liorknafo/totem-aluminum-case/outputs/clearance_L.png

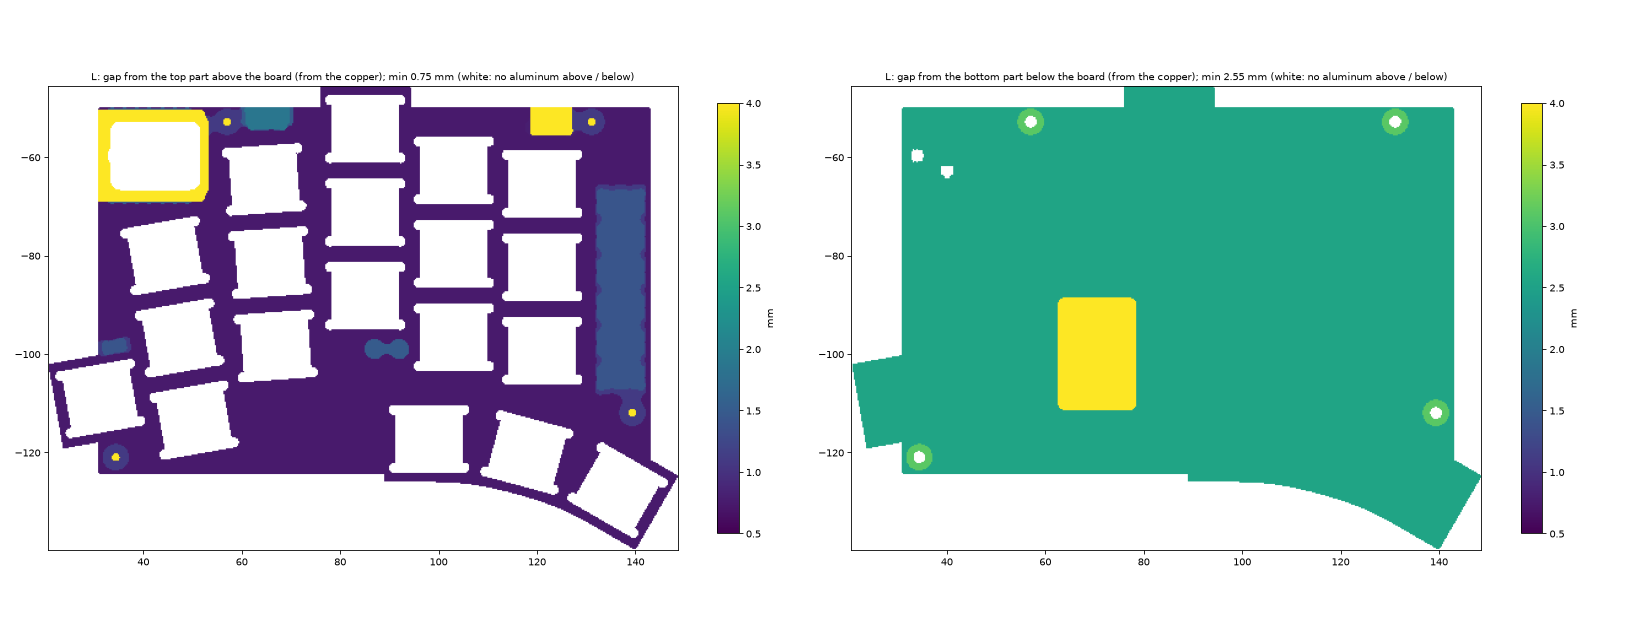
outputs/clearance_L.png
