liorknafo/totem-aluminum-case/outputs/heightmap_L.png

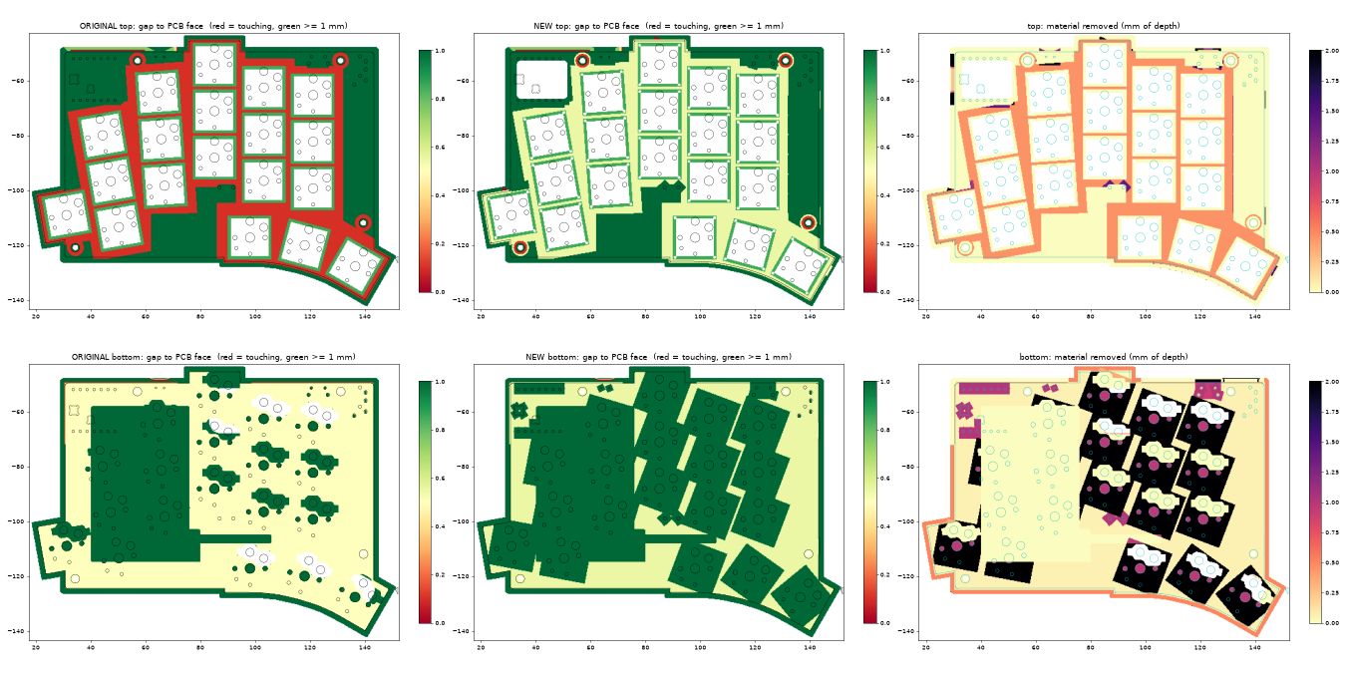
outputs/heightmap_L.png
