liorknafo/totem-aluminum-case/outputs/heightmap_R.png

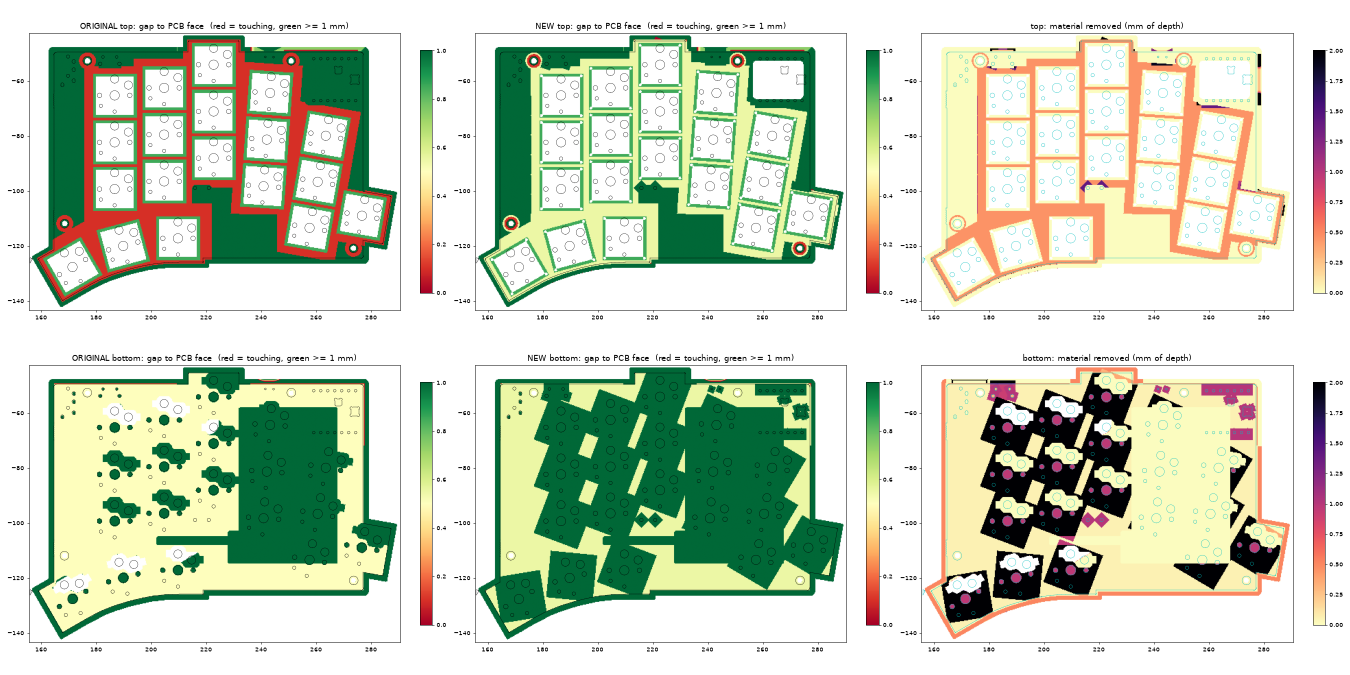
outputs/heightmap_R.png
