liorknafo/totem-aluminum-case/outputs/openings_L.png

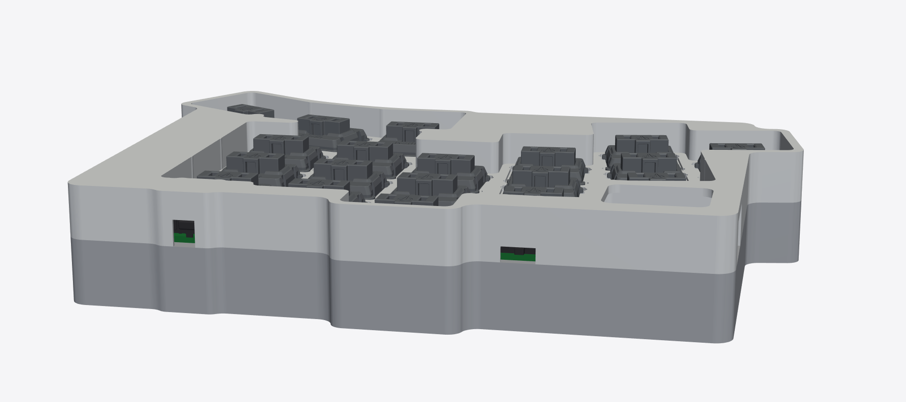
outputs/openings_L.png
