liorknafo/totem-aluminum-case/outputs/render3d_L.png

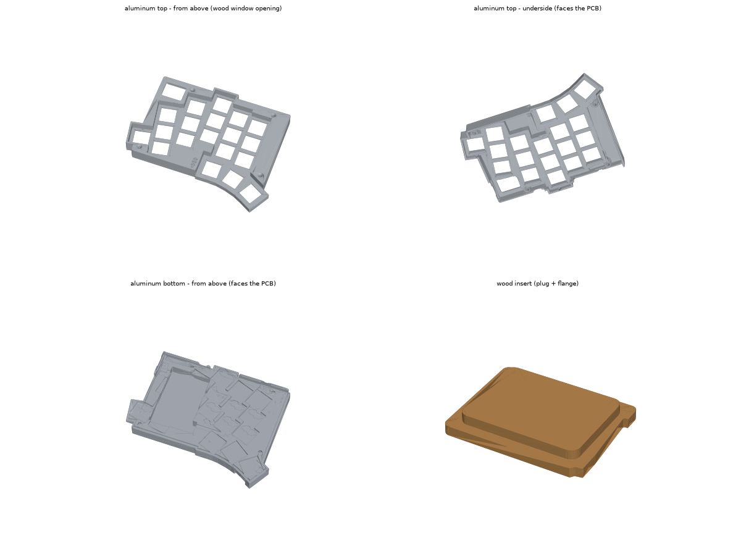
outputs/render3d_L.png
