liorknafo/totem-aluminum-case/outputs/reset_back.png

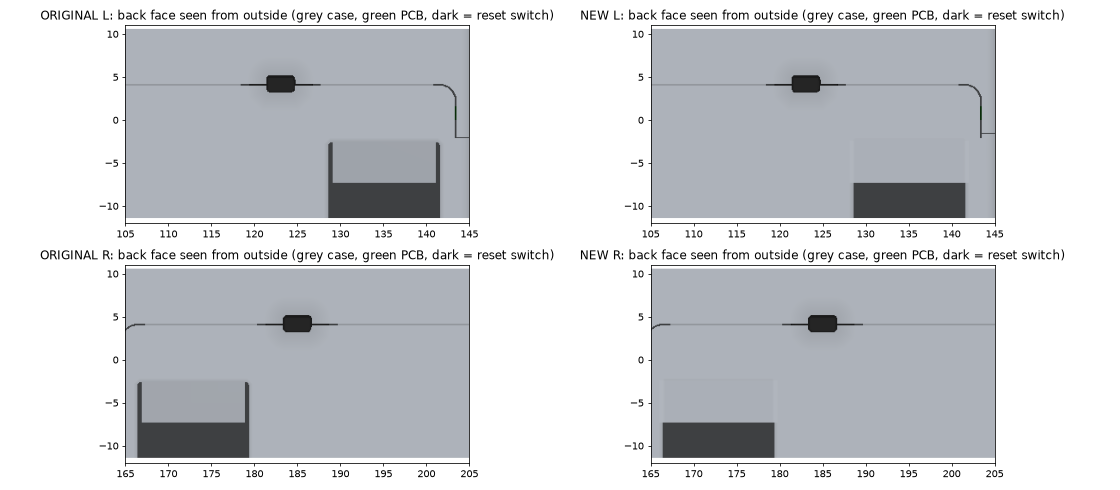
outputs/reset_back.png
