liorknafo/totem-aluminum-case/outputs/sections_L.png

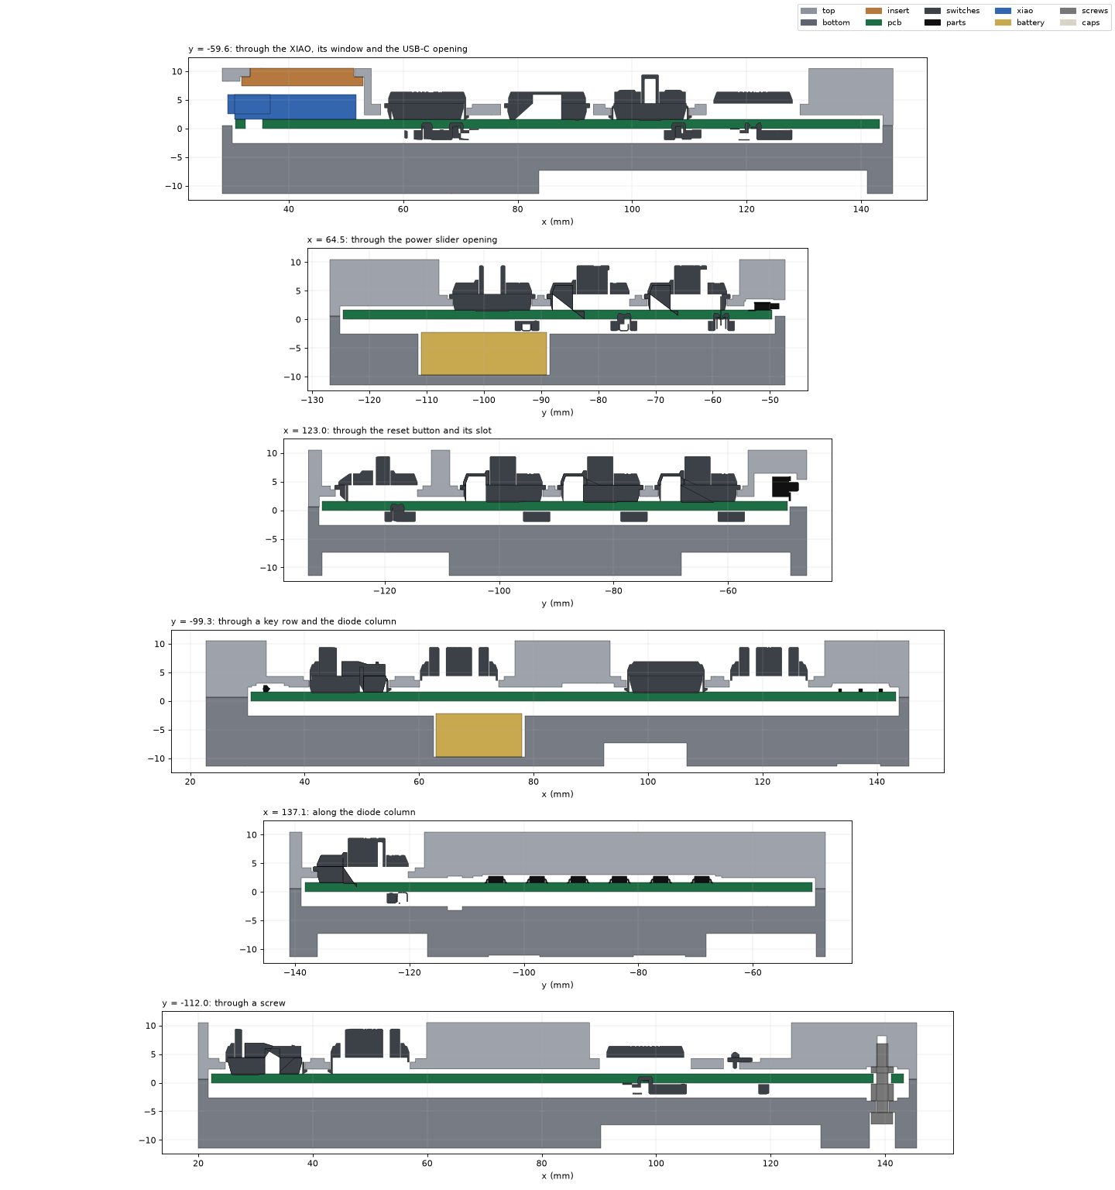
outputs/sections_L.png
