liorknafo/totem-aluminum-case/outputs/underside_holes.png

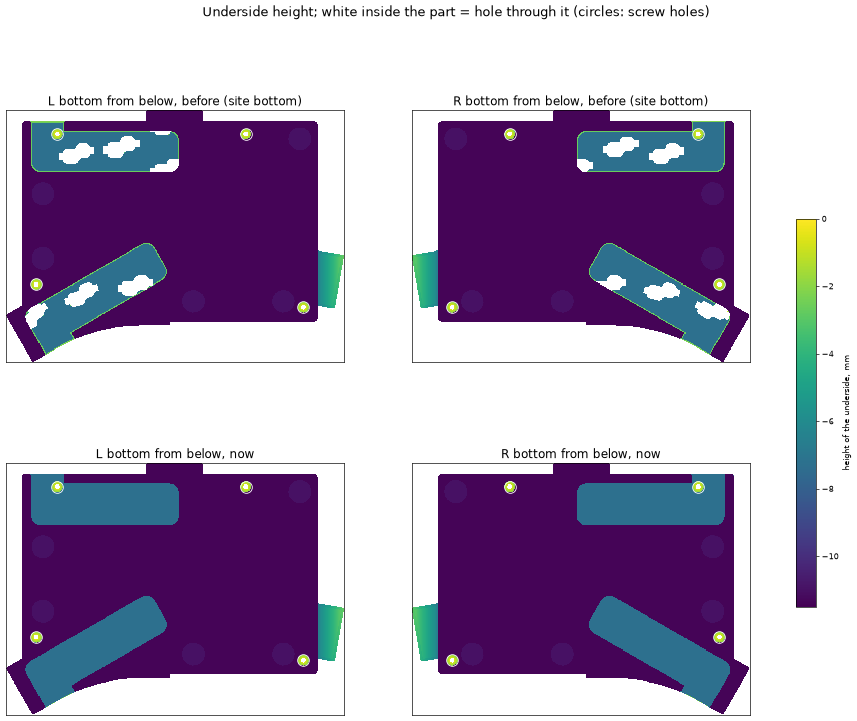
outputs/underside_holes.png
