liorknafo/totem-aluminum-case/outputs/TOTEM_wood_window_insert_L.step

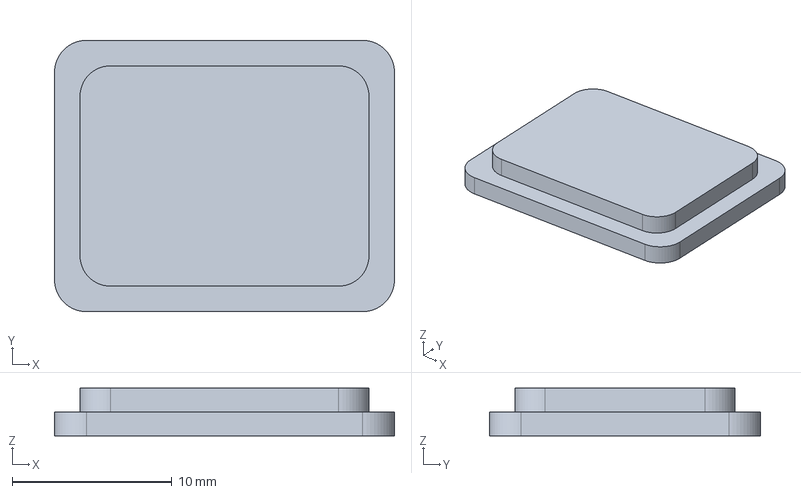
[picture p15: CAD file, 2026-11-09]
outputs/TOTEM_wood_window_insert_L.step
21.3 x 17.0 x 3.00 mm
