liorknafo/totem-aluminum-case/src/pcb_board.step

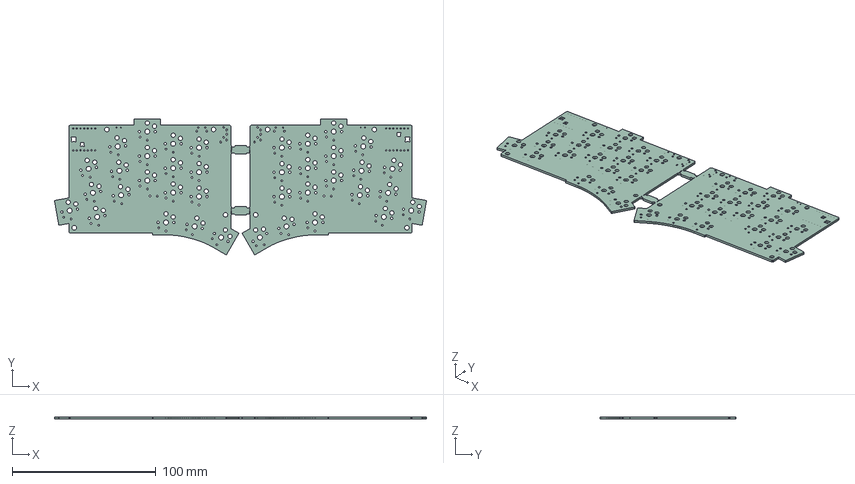
[picture p16: CAD file, 2026-10-20]
src/pcb_board.step
258.7 x 94.4 x 1.51 mm
