liorknafo/totem-aluminum-case/work/orig/TOTEM_tenting_live_bottom_L.step

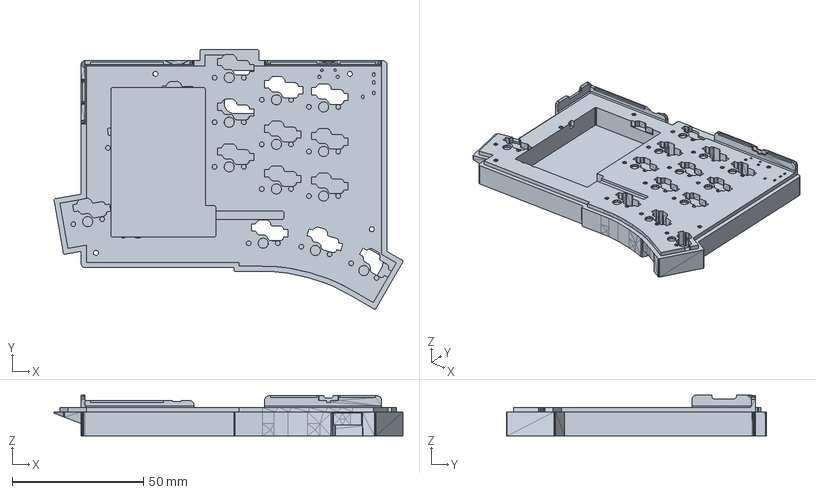
[picture p17: CAD file, 2026-10-20]
work/orig/TOTEM_tenting_live_bottom_L.step
133.1 x 99.0 x 15.6 mm
