liorknafo/totem-aluminum-case/outputs/TOTEM_alu_bottom_L.step

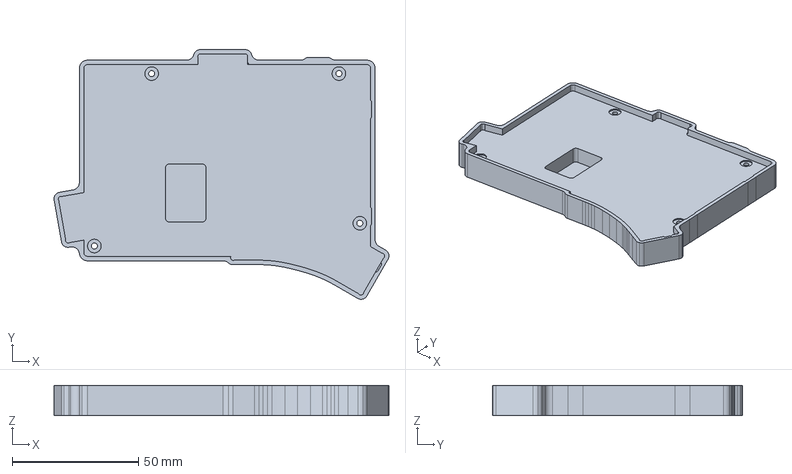
[picture p18: CAD file, 2026-11-09]
outputs/TOTEM_alu_bottom_L.step
132.8 x 98.9 x 12.0 mm
