liorknafo/totem-aluminum-case/src/comp_all.step

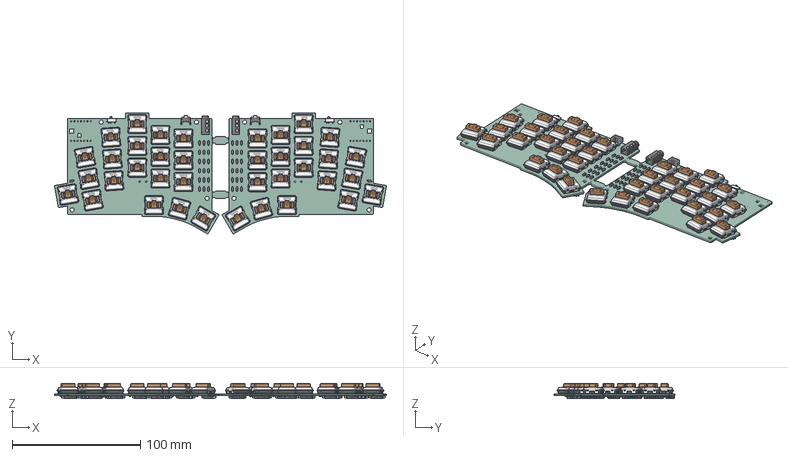
[picture p19: CAD file, 2026-10-20]
src/comp_all.step
258.7 x 94.4 x 11.4 mm
Kailh_switch_PG1350_optional x 38
pin x 76
socket x 38
D_SOD-123 x 38
PJ320A x 2
MSK12C02 x 2
SKHL-L^SKHLLC x 2
board_abs_PCB
