liorknafo/totem-aluminum-case/work/orig/TOTEM_tenting_live_bottom_R.step

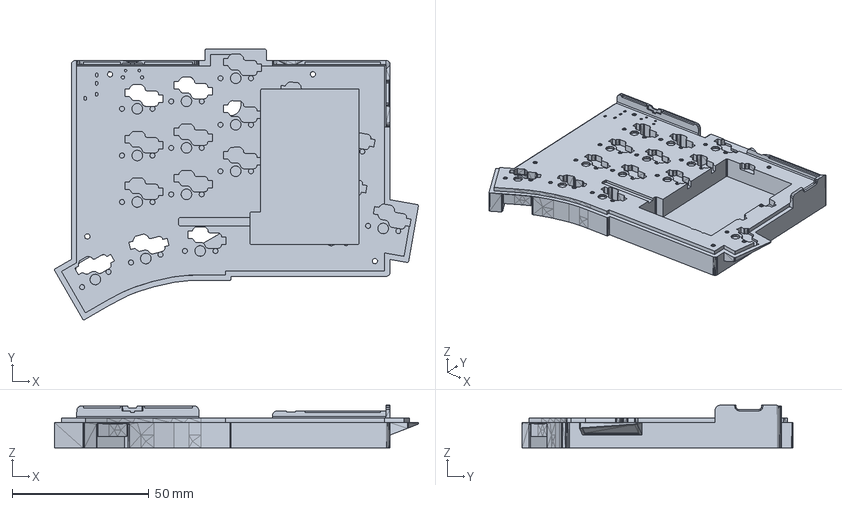
[picture p20: CAD file, 2026-10-20]
work/orig/TOTEM_tenting_live_bottom_R.step
133.1 x 99.0 x 15.6 mm
