liorknafo/totem-aluminum-case/outputs/TOTEM_alu_top_L.step

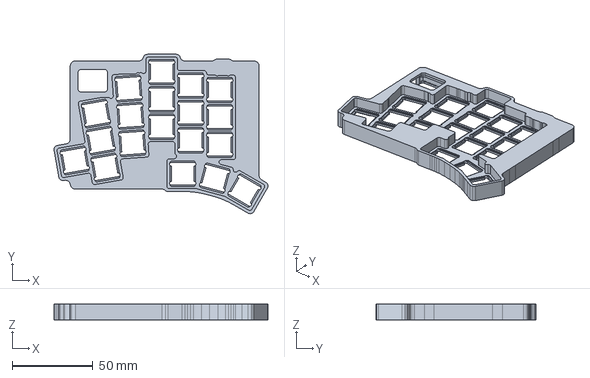
[picture p21: CAD file, 2026-11-09]
outputs/TOTEM_alu_top_L.step
132.8 x 98.9 x 9.90 mm
