liorknafo/totem-aluminum-case/src/pads.step

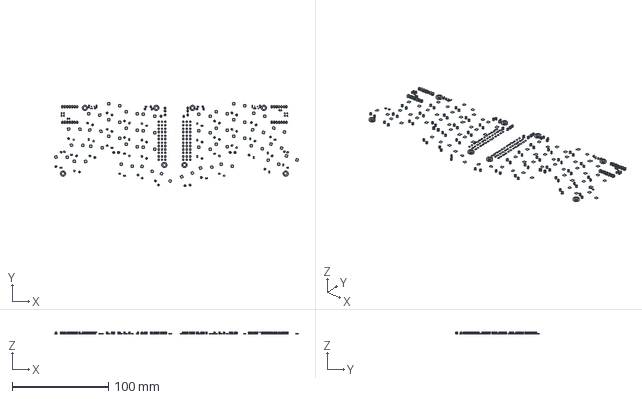
[picture p22: CAD file, 2026-10-20]
src/pads.step
253.6 x 87.6 x 1.59 mm
