liorknafo/totem-aluminum-case/outputs/TOTEM_alu_bottom_R.step

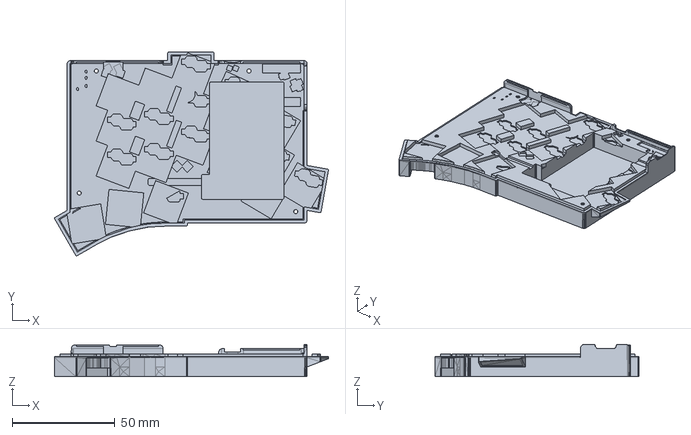
[picture p23: CAD file, 2026-10-20]
outputs/TOTEM_alu_bottom_R.step
133.1 x 99.0 x 15.6 mm
