liorknafo/totem-aluminum-case/outputs/TOTEM_alu_top_R.step

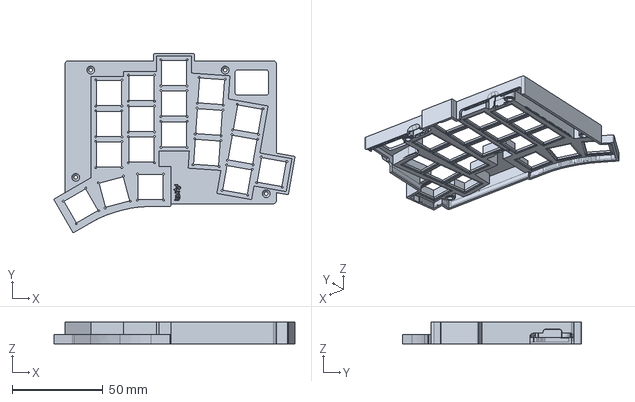
[picture p24: CAD file, 2026-10-20]
outputs/TOTEM_alu_top_R.step
133.1 x 99.0 x 12.0 mm
