liorknafo/totem-aluminum-case/(list of files, cad)

Other CAD files:
outputs/TOTEM_wood_window_insert_R.step
