liorknafo/totem-aluminum-case/(commit log)

2026-10-20 TOTEM BLE case for aluminum: no contact with the PCB
    Aluminum top and tenting bottom for both halves, reworked from the
    TOTEM BLE case so every aluminum surface keeps 0.5 mm from the board,
    its pads and its metal parts; wood windows over the XIAO BLE for
    Bluetooth; blind socket pockets (only the screw holes go through the
    bottom). Fits 105 x 140 mm stock: 1/2" tops, 7/8" bottoms.
    Includes the build and check scripts, the input case copies and the
    TOTEM PCB data used to measure clearances.
2026-10-20 README: renders of the case
    Six stills of the final STEP files (assembled with and without keycaps,
    exploded, see-through top, underside, side) in docs/images, rendered
    from the same scene as the interactive 3D view.
2026-11-09 Rebuild the aluminum case as a parametric model generated from the PCB
    Replace the modified copies of the original case files with a new
    2.5D design built by work/build.py from src/totem_0_3.kicad_pcb (outline,
    footprints, pads) and the KiCad part models. Every part is a few
    extruded planar regions made of exact lines and arcs, so the STEP files
    hold only planes and cylinders; both halves build in about 30 s.
    - top: flat deck, key wells, 1.2 mm clip plate with 13.8 mm cut-outs and
    corner reliefs for a 2 mm end mill, blind pockets per part height,
    back-wall openings for USB-C, power slider and reset, wood window
    - bottom: cavity under the board, battery pocket, tenting-leg and feet
    rec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
2026-11-09 Place parts from the board file, add spacers at the mounting pads, 0.5 mm at the reset plunger
    Review fixes:
    - part geometry now comes from each footprint's (model ...) entry and the
    model files in src/TOTEM3D (KiCad's placement convention), so moving a
    footprint moves only its own pocket; KiCad's STEP exports are only
    cross-checked (parts and pads match the board file to 0.0 mm)
    - insulating spacers above and below the four no-net mounting pads, in
    shallow seats in the roof and floor, stop 0.1 mm from the pads; the
    aluminum keeps 0.5 mm from the board
    - the reset slot keeps 0.5 mm around the plunger and the power slider knob
    keeps 0.5 mm over its travel; the build asserts it
    - c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
2026-11-09 Use each footprint's own 3D model entries; add the footprint-edit regression test
    Part geometry, the build's part boxes and the actuator boxes are now keyed
    by each footprint's own (model ...) entries, not by its library: editing
    one footprint's model offset no longer moves the parts of every footprint
    of that type. The 3D view instances the most common model per kind and
    draws footprints with other entries on their own.
    work/test_variants.py rebuilds scratch copies with one footprint edited
    (a position, and model offsets on first and non-first diodes on both
    halves) and checks that the other half is identical and the clearances
    hold.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
2026-11-09 Identify part models by their full path; test model-file edits
    A footprint's model identity is now the full normalized model path (plus
    offset, rotation and scale), resolved like KiCad does, so two model files
    with the same name in different folders no longer share geometry in the
    build, the checks or the viewer.
    test_variants.py now also swaps a diode's model for a same-named file in
    another folder (a non-first and the last diode), builds every variant
    with an empty and then a warm part cache, and measures the edited parts
    against their model files loaded and placed by separate code.
2026-11-09 CHECKS.md: say that every measurement is against the board file and its models
2026-11-09 Seat the switches on the plate at the model's shoulder; stop for other board thicknesses
    - the plate top is now z 3.60, the shoulder of the switch model on the
    1.6 mm board (it was 3.65 from the original case, which put a 0.05 mm
    band of every switch housing inside the plate); the plate is 2.40-3.60
    and the latches catch 0.14 mm under it. The build asserts both against
    the switch model; the checks measure switch bodies against the top
    (0.0 mm3 overlap).
    - the board thickness comes from the board file; build and checks stop
    with an explanation unless it is the 1.6 mm the part models assume,
    instead of silently using a different board.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
2026-11-09 CHECKS.md: say where and why the walls are under the 1.0 mm aim
